FITLab-Swansea/PV-Tiles/Software code/README.md

# PV-Tiles
Implementation of PV-tile prototype: kitchen and tabletop scenario demonstrator

## Getting Start
After integrating hardware design with the material, the following instruction is used to create prototypes for kitchen and tabletop scenarios.

*Download and install the Energia IDE

*Get the SharpÂ® 128x128 Memory LCD Library

*Get SharpÂ® 128x128 Memory LCD and microSD Card TI BoosterPack

*Get MSP430FR5969 Ultra-Low-Power Microcontroller

*Implement the software code for interactive demonstrators

*Use ImageDog.java - A command line image converter to create C data structures that can be efficiently processed by DOGS102x-6 displays.
