FITLab-Swansea/PV-Tiles/Hardware design/Functional block diagram.pdf

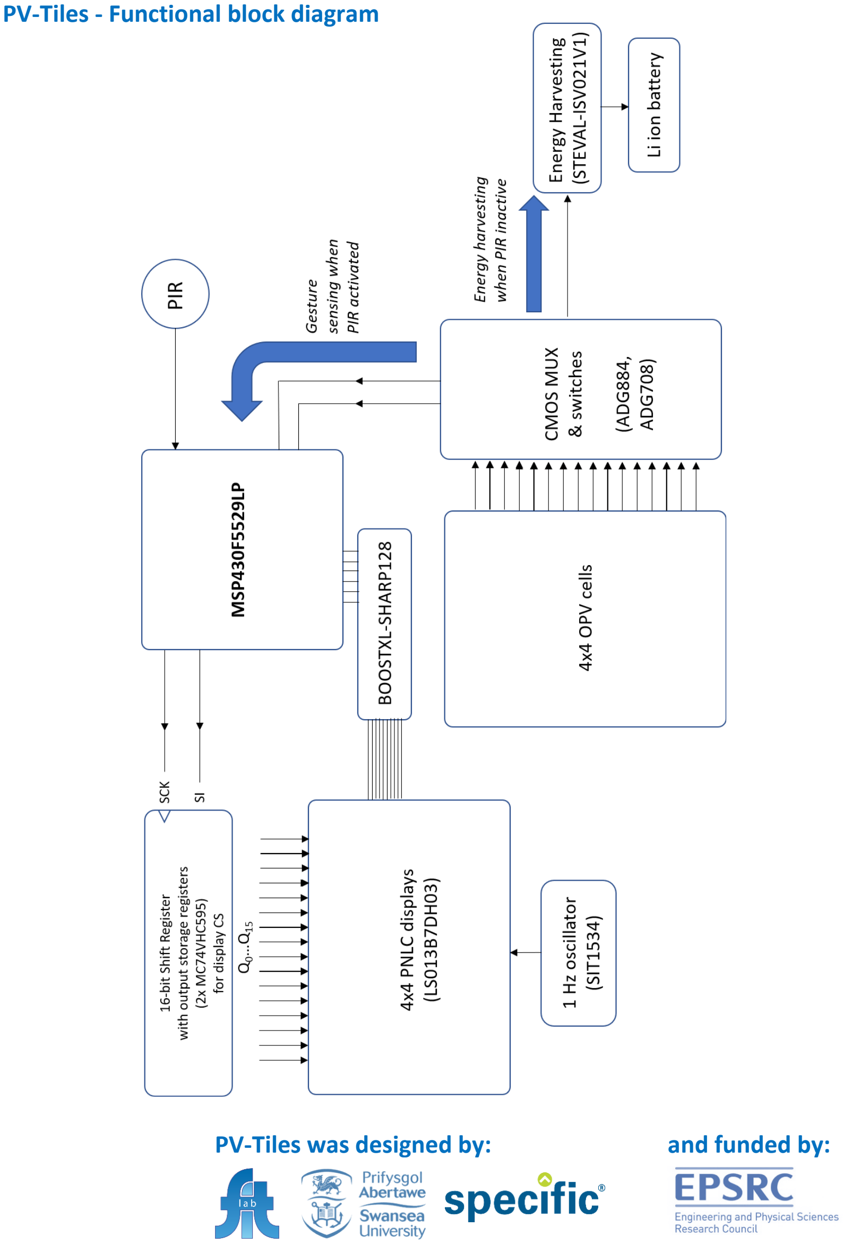
[picture p1: page 1]

PV-Tiles - Functional block diagram

PV-Tiles was designed by: | and funded by:
