FITLab-Swansea/PV-Tiles/PV fabrication process/README.md

# Organic photovoltaic (OPV) cells fabrication

The fabrication process includes cleaning, solution preparation, spin coating, electrodes, encapsulation, and electrode evaporation.
