FITLab-Swansea/PV-Tiles/Hardware design/Printed circuit board.pdf

### PV-Tiles - Printed circuit board

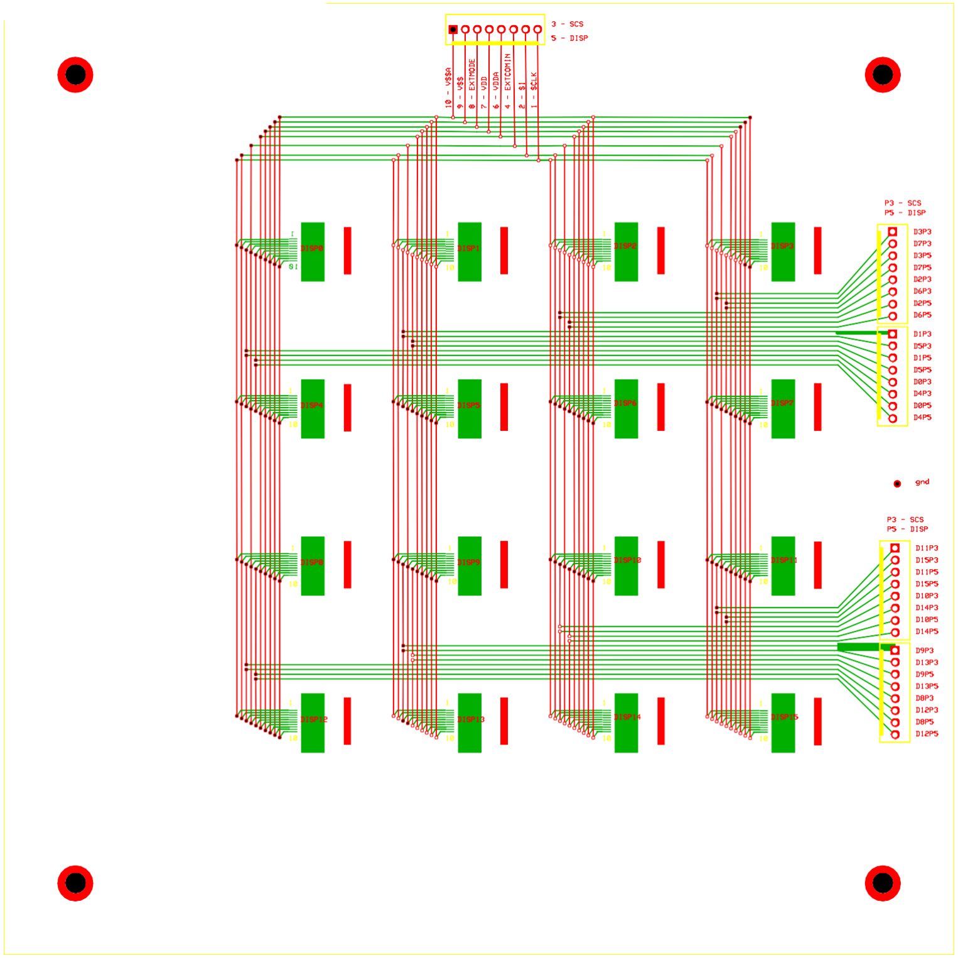
[picture p2: figure]

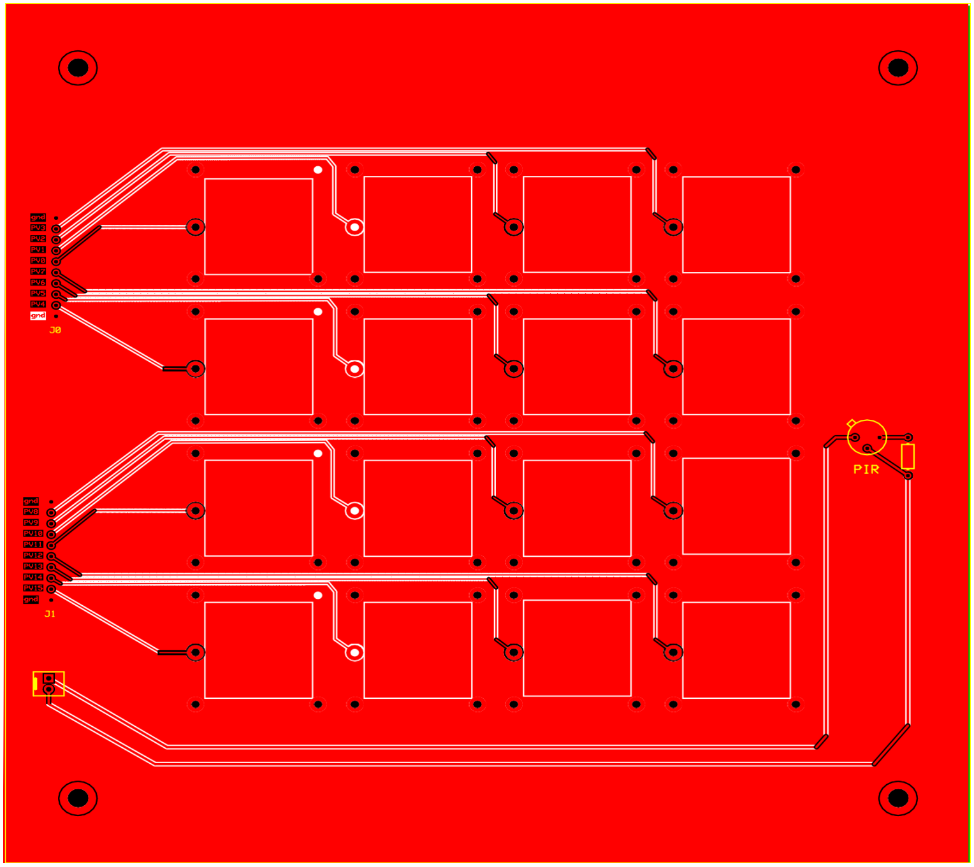
[picture p3: figure]

PV-Tiles was designed by: | and funded by:
