FITLab-Swansea/PV-Tiles/Hardware design/Analog_switches_MUX_board.pdf

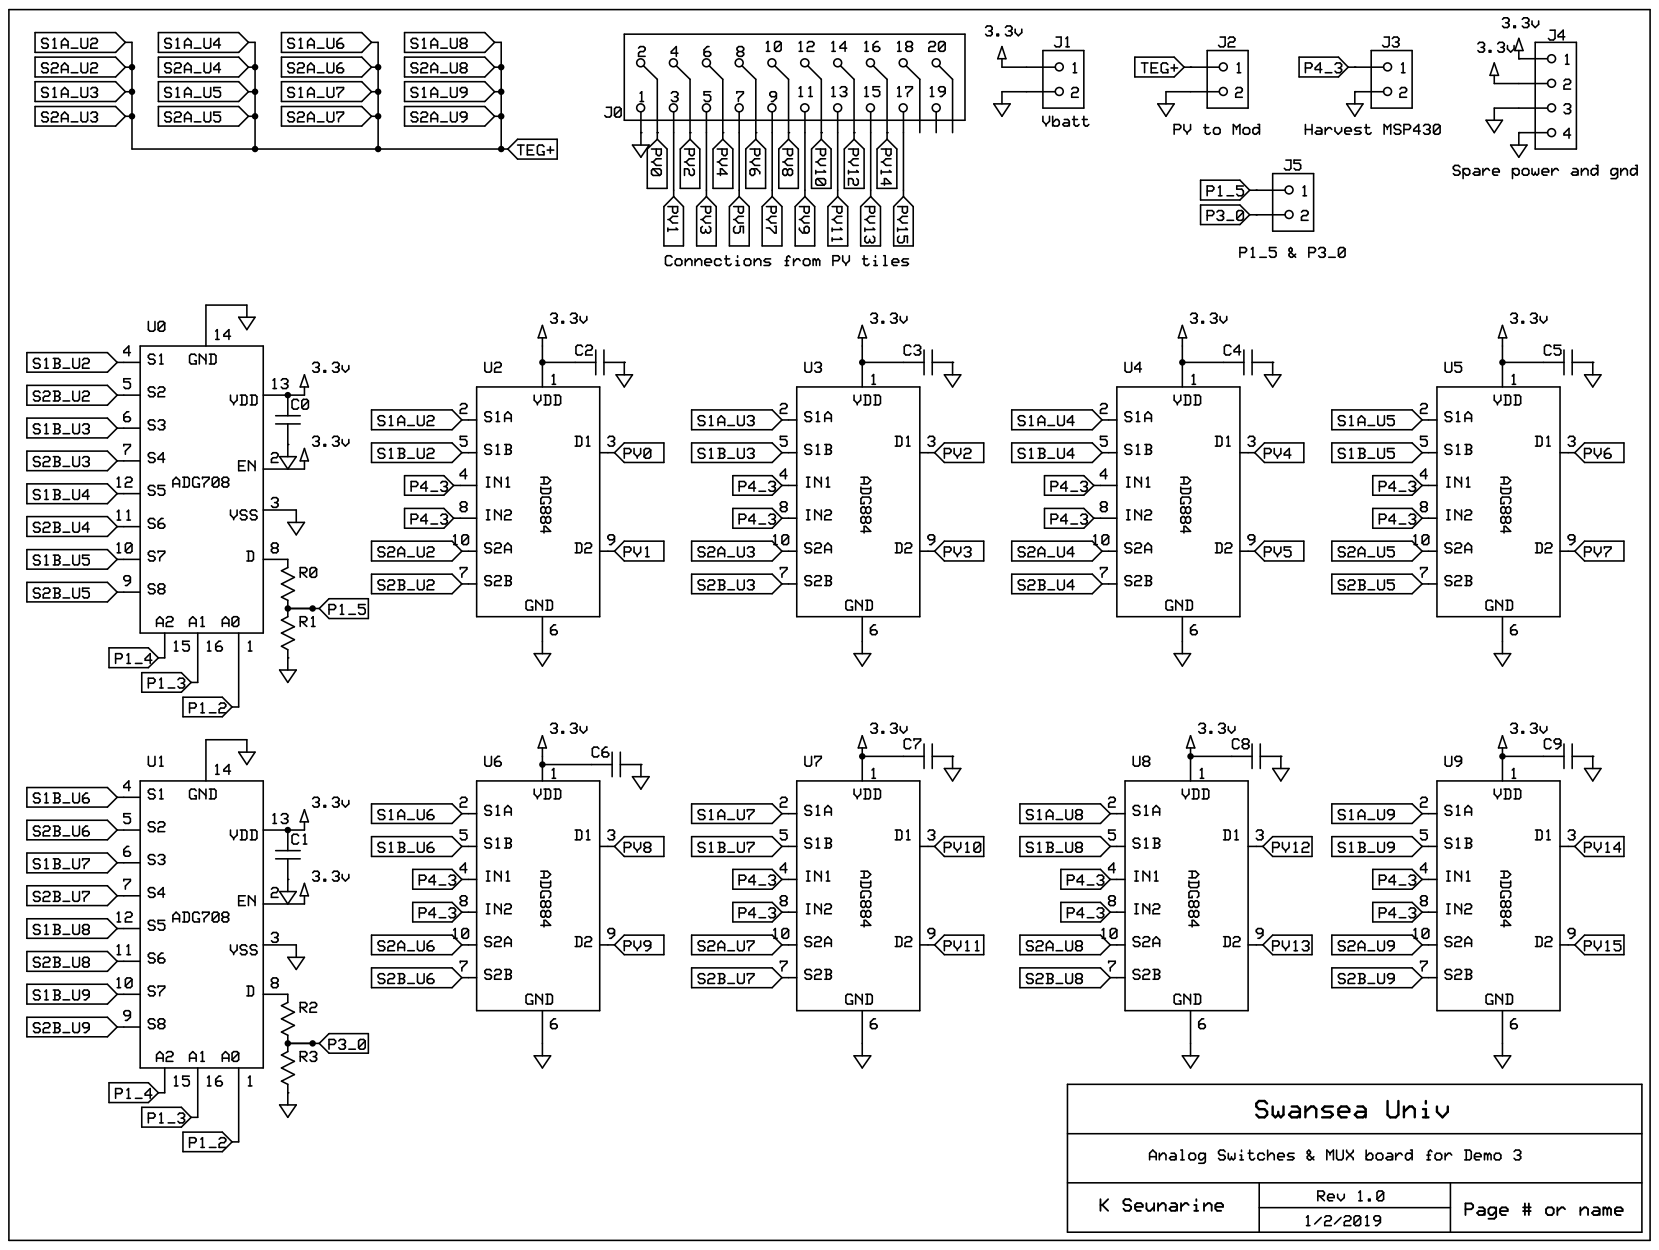
[picture p5: page 1]
